KSP4EVER/rad_detector_v500/README.md

# rad_detector_v500
Geiger tube based radiation detector
