KSP4EVER/rad_detector_v500/HW/rad_detector_v500/Project Outputs for rad_detector_v500/rad_detector_v500_BOM.xlsx

Name | Designator | Quantity | Distributor | Part Number
10uF | C1, C7, C10, C12 | 10 | MOUSER | 963-TMK325BJ106MN-T
100nF | C2, C5, C8, C11, C14, C15, C16, C30 | 20 | MOUSER | 80-C0805C104K8RAUTO
10nF | C3, C4, C32 | 5 | MOUSER | 581-08055C103M4T2A
22pF | C18, C19 | 5 | MOUSER | 80-C0805C220J8GAUTO
1uF | C25, C26, C27 | 5 | MOUSER | 963-MCAST21GSB7105MT
USBLC6-2SC6 | D5 | 3 | MOUSER | 511-USBLC6-2SC6
10k | R10, R14, R15, R16, R18, R20, R21, R22, R28, R29, R31, R39, R40, R41, R42, R43, R57, R58 | 30 | MOUSER | 603-RC0805FR-0710KL
2k | R13 | 5 | MOUSER | 652-CMP0805QFX-1001E
1.5k | R35 | 10 | MOUSER | 71-CRCW0805J-1.5K-E3
4.7M | R53 | 5 | MOUSER | 667-ERJ-U06J475V
DTSA 62N | SW1, SW2, SW3 | 3 | MOUSER | 113-DTSA-62N-V
BCP54 | T1 | 3 | MOUSER | 771-BCP54115
BC848* | T2 | 5 | MOUSER | 863-BC848BLT3G
BSS84 | T3 | 2 | MOUSER | 821-BSS84
MMBF170 | T4, T5, T6 | 5 | MOUSER | 621-MMBF170Q-7-F
BC856 | T9, T11 | 5 | MOUSER | 771-BC856B-T/R
LM393D | U1 | 2 | MOUSER | 511-LM393DT
MCP73832T-2ATI/OT | U2 | 2 | MOUSER | 579-MCP73832T-2ACIOT
MIC5504-3.3YM5-TR | U3 | 5 | MOUSER | 998-MIC5504-3.3YM5TR
LTC2955CTS8-1#TRPBF | U5 | 1 | MOUSER | 584-C2955CTS8-1TMPF
M24C02-DRDW8TP/K | U7 | 5 | MOUSER | 511-M24C02-DRDW8TP/K
STM32F103CBT6 | U8 | 1 | MOUSER | 511-STM32F103CBT6
EADOGS102W-6 BACKLIGHT | U9 | 1 | TME | https://www.tme.eu/hu/details/ealed39x41-a/kijelzo-kellekek/display-visions/ea-led39x41-a/
EADOGS102W-6 | U9 | 1 | TME | https://www.tme.eu/hu/details/eadogs102w-6/grafikus-lcd-kijelzok/display-visions/ea-dogs102w-6/
HCM1212X | U10 | 2 | MOUSER | 490-CEM-1206S
74HCT123 | U11 | 1 | TME | https://www.tme.eu/hu/details/74hct123d.653/multivibratorok/nexperia/74hct123d-653/
