KSP4EVER/rad_detector_v500/HW/rad_detector_v500/rad_detector_v500.step

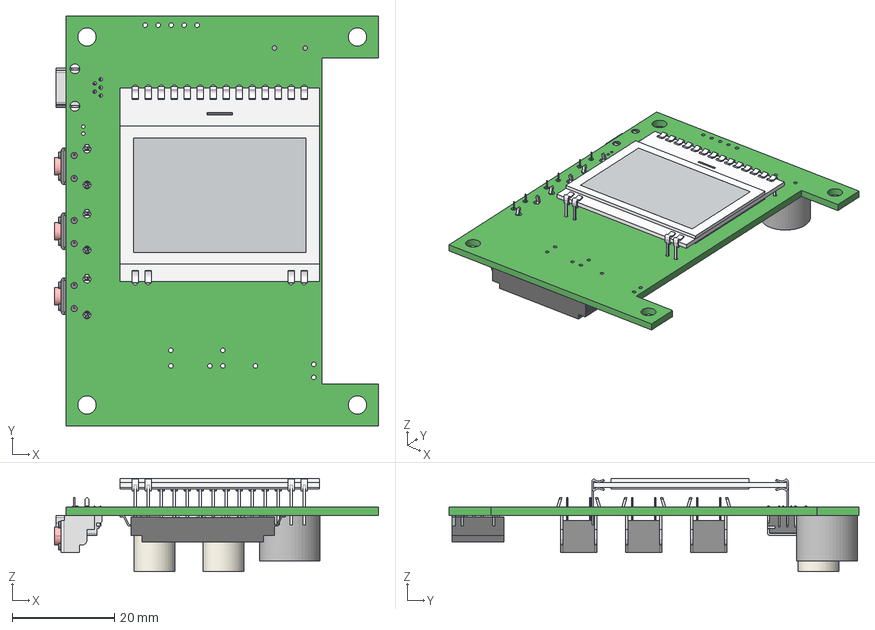
[picture p14: CAD file, 2023-11-11]
HW/rad_detector_v500/rad_detector_v500.step
63.3 x 80.0 x 18.3 mm
DOGS102N-6
User Library-switch diptronics dtsa-62 x 3
usb_mn_2_b
Extruded x 2
