KSP4EVER/rad_detector_v500/(list of files, drawings)

Other design files:
HW/rad_detector_v500/rad_detector_v500.PcbDoc
HW/rad_detector_v500/rad_detector_v500.PrjPcb
HW/rad_detector_v500/rad_detector_v500_ANA.SchDoc
HW/rad_detector_v500/rad_detector_v500_CONN.SchDoc
HW/rad_detector_v500/rad_detector_v500_HV_PSU.SchDoc
HW/rad_detector_v500/rad_detector_v500_MAIN.SchDoc
HW/rad_detector_v500/rad_detector_v500_MCU.SchDoc
HW/rad_detector_v500/rad_detector_v500_PERIPHERAL.SchDoc
HW/rad_detector_v500/rad_detector_v500_PSU.SchDoc
