KSP4EVER/rad_detector_v500/SW/Core/Inc/main.h

#define BEEP_WIDTH_Pin GPIO_PIN_14
#define BEEP_WIDTH_GPIO_Port GPIOC
#define BATT_MEAS_TOOGLE_Pin GPIO_PIN_3
#define BATT_MEAS_TOOGLE_GPIO_Port GPIOA
#define BTN_UP_DOWN_Pin GPIO_PIN_5
#define BTN_UP_DOWN_GPIO_Port GPIOA
#define BTN_CLEAR_Pin GPIO_PIN_6
#define BTN_CLEAR_GPIO_Port GPIOA
#define USB_CHARGE_Pin GPIO_PIN_0
#define USB_CHARGE_GPIO_Port GPIOB
#define KILL_Pin GPIO_PIN_1
#define KILL_GPIO_Port GPIOB
#define SYS_BEEP_Pin GPIO_PIN_2
#define SYS_BEEP_GPIO_Port GPIOB
#define LCD_RST_Pin GPIO_PIN_8
#define LCD_RST_GPIO_Port GPIOA
#define LCD_BACKLIGHT_DIMM_Pin GPIO_PIN_9
#define LCD_BACKLIGHT_DIMM_GPIO_Port GPIOA
#define FLYBACK_PWM_Pin GPIO_PIN_9
#define FLYBACK_PWM_GPIO_Port GPIOB
