KSP4EVER/rad_detector_v500/(notices)

Notices in the files:
SW/Core/Inc/main.h:
Copyright (c) 2023 STMicroelectronics.
All rights reserved.
This software is licensed under terms that can be found in the LICENSE file
